aaronadamski/brainsolutions-eegboard/README.md

# brainsolutions-eegboard
EEG Prototype Board for UCI Senior Design

For use in KiCAD EDA Suite.
