aaronadamski/brainsolutions-eegboard/EEG_v2_BOM.xlsx

PrePurch? | ref | Quantity | value | Manufacturer | Part Number | footprint
N | C56 | 1 | 0.5p | Murata | GRM1555C1HR50BZ01D | 0402_NP0_B_50
N | C57 C58 | 2 | 12p | Murata | GRM1555C1H120JA01D | 0402_NP0_J_50
N | C51 C52 | 2 | 15p | Murata | GRM1555C1H150JA01D | 0402_NP0_J_50
N | C54 C55 | 2 | 47p | Murata | GRM1555C1H470JA01D | 0402_NP0_J_50
N | C59 | 1 | 1n | Murata | GRM1555C1H102JA01D | 0402_NP0_J_50
Y | C13 | 1 | 1.5nF | AVX | 08055C152KAT2A | 0805
N | C1 C4 C5 C6 C9 C10 C14 C15 C23 C24 C27 C28 C29 C30 C31 C32 C33 | 17 | 4.7nF | Murata | GRM188R71H472KA01D | 0603_X7R_50
Y | C42 | 1 | 0.01uF | AVX | 08055C103KAT2A | 0805
N | C3 C8 C12 C18 C21 | 5 | 0.1uF | Murata | GRM188R71H104KA93D | 0603_X7R_50
N | C43 C44 C45 C46 C47 C48 C49 C50 C53 | 9 | 1u | Murata | GRM155R60J105KE19D | 0402_X5R_K_6P3
N | C2 C7 C11 C17 C19 C20 C25 C26 C34 C35 C36 C37 | 12 | 1uF | Murata | GRM188R61E105KA12D | 0603_X5R_25
Y | C38 C41 | 2 | 1uF | AVX | 08055YC105KAT2A | 0805
Y | C39 C40 | 2 | 2.2uF | AVX | 0805ZD225MAT2A | 0805
Y | C22 | 1 | 10uF | AVX | 08056D106MAT2A | 0805_X5R_10
Y | C16 | 1 | 100uF | AVX | F930J107MBA | 1210_X5R_10
N | D1 | 1 | LED_EL19-21SURC | Everlight | EL-19-21SURC/S530-A2/TR8 | 0603
N | D2 | 1 | LED_EL19-21SYGC | Everlight | 19-21SYGC/S530-E1/TR8 | 0603
 | JP1 | 1 | JUMPER |  |  | 2x1 0.1"
N | L1 | 1 | EMI | Murata | BLM15HG102SN1D | 0402
 | P1 | 1 | CONN_2 |  |  | 2x1 0.1"
 | P6 | 1 | CONN_3 |  |  | 3x1 0.1"
N | P3 | 1 | USB-MINI-B | Molex | 47346-0001 | 47346-0001
 | P5 | 1 | CONN_5X2 |  |  | 5x2 0.1"
 | P2 P4 | 2 | CONN_8 |  |  | 8x1 0.1" |  | Footprints to do
N | R21 | 1 | 0 | KOA | RK73Z1ETTP | 402 | x | 2x1 0.1"
N | R23 R24 | 2 | 33 | KOA | RK73H1ETTP33R0F | 0402_G | x | 8x1 0.1"
N | R25 R26 | 2 | 270 | KOA | RK73H1ETTP2700F | 0402_F | x | 3x1 0.1"
N | R27 | 1 | 2.2k | KOA | RK73H1ETTP2201F | 0402_G | x | 5x2 0.1"
N | R2 R3 R4 R5 R6 R7 R8 R10 R11 R12 R13 R14 R15 R16 R17 R18 R19 R20 | 18 | 4.99K | Vishay | CRCW06034K99FKEA | 0603 | x | 47346-0001
N | R1 | 1 | 10K | Vishay | CRCW060310K0FKEA | 0603 | x | thru 1825910
N | R22 | 1 | 56k | KOA | RK73H1ETTP5602F | 0402_F | x | VQFN40
Y | R9 | 1 | 1M | Vishay | CRCW08051M00FKEA | 0805 |  | 2450bm15a0002e
N | SW1 | 1 | SWITCH_INV | ALPS | SSSS810701 | SSSS810701 | x | crystal1
 | SW2 | 1 | RESET | TE Connectivity | 2-1825910-7 | Thru 1825910 | x | crystal2
N | SW3 SW4 | 2 | SW_PUSH | TE Connectivity | 2-1825910-7 | Thru 1825910 | x | ssss810701
 | TP2 | 1 | 2.5V |  | N/A | Meas_Pt
 | TP1 | 1 | 3.3V |  | N/A | Meas_Pt
 | TP3 | 1 | -3.3V |  | N/A | Meas_Pt
 | TP4 | 1 | -2.5V |  | N/A | Meas_Pt
N | U7 | 1 | 2450BM15A0002E | Johanson | 2450BM15A0002E | 2450BM15A0002E
Y | U4 | 1 | LM2664 | TI | LM2664M6X/NOPB | SOT23-6
Y | U1 | 1 | ADS1299IPAGR | TI | ADS1299IPAGR | TQFP64
Y | U2 | 1 | TLV70033 | TI | TLV70033DDCR | TSOT23-5
Y | U3 | 1 | TLV70025 | TI | TLV70025DDCR | TSOT23-5
Y | U5 | 1 | TPS72325 | TI | TPS72325DBVR | TSOT23-5
Y | U6 | 1 | CC2540 | TI | CC2540F256RHAR | VQFN40
N | X2 | 1 | 32-MHz | Epson | FA-128 32.0000MF20X-K3 | 10/20/60/10
N | X1 | 1 | 32.768-KHz | Epson | FC-135 32.7680KA-A3 | ~
