aaronadamski/brainsolutions-eegboard/Reference designs/eval/CC2540EM_discrete_partlist.xls

Sheet: Partlist TI LPW
CC2540EM discrete 1.5.1
Mark assembled PCB "CC2540EM_D_R1.5.1"
Use with PCB rev 1.5
Ref. | Part name | Pcs/unit | Description | Manufacturer | Part number | Supplier | Ordering code | Alt. Manufacturer | Alt. Part number | Alt. Supplier | Alt. Ordering code | Comments
U1 | CC2540 | 1 | 2.4 GHz SoC | TI | CC2540 | TI | CC2540
C2 | C_0402 | 0 | Capacitor, general, 0402; Do not mount
C101;C211;C241;C271;C311 | C_100N_0402_X5R_K_10 | 5 | Capacitor, 100n, 0402, X5R, 10%, 10V | Murata | GRM155R71A104KA01D
C221;C231 | C_12P_0402_NP0_J_50 | 2 | Capacitor, 12p, 0402, NP0, 5%, 50V | Murata | GRM1555C1H120JZ01D
C321;C331 | C_15P_0402_NP0_J_50 | 2 | Capacitor, 15p, 0402, NP0, 5%, 50V | Murata | GRM1555C1H150JZ01D
C251;C261 | C_18P_0402_NP0_J_50 | 2 | Capacitor, 18p, 0402, NP0, 5% 25V | Murata | GRM1555C1H180JZ01D | ELFA | 65-881-23
C201 | C_1N_0402_NP0_J_50 | 1 | Capacitor, 1n, 0402, NP0, 5%, 50V | Murata | GRM1555C1H102JA01D
C252-253;C262 | C_1P0_0402_NP0_C_50 | 3 | Capacitor, 1p, 0402, NP0, +/-0.25pF 50V | Murata | GRM1555C1H1R0CZ01D
C391;C401 | C_1U_0402_X5R_K_6P3 | 2 | Capacitor, 1u, 0402, X5R, 10%, 6.3V | Murata | GRM155R60J105KE19D
C272 | C_220P_0402_NP0_J_50 | 1 | Capacitor, 220p, 0402, NP0, 5%, 50V | Murata | GRM1555C1H221JA01D
C1 | C_2U2_0402_X5R_M_6P3VDC | 1 | Capacitor, 2u2, 0402, X5R, +/-20%, 6.3V | Murata | GRM155R60J225ME | TTI
L252 | L_1N0_0402_S | 1 | Inductor, 1n0, 0402, Monolithic type, +/-0.3 nH | Murata | LQG15HS1N0S02D |  |  | Coilcraft
L251;L261 | L_2N0_0402_S | 2 | Inductor, 2n0, 0402, +/-0.3 nH | Murata | LQG15HS2N0S02D
L253 | L_3N0_0402_S | 1 | Inductor, 3n0, 0402, Monolithic type, +/-0.3 nH | Murata | LQG15HS3N0S02D | ACTE |  | Coilcraft
L1 | L_BEAD_102_0402 | 1 | EMI filter bead, 0402 1Kohms Tape GHz Band Gen Use | Murata | BLM15HG102SN1D | ACTE
R1-4 | R_0402 | 0 | Resistor, general, 0402; Do not mount
R201 | R_2K7_0402_F | 1 | Resistor, 2k7 ohms, 0402, ±1% | Koa | RK73H1ETTP2701F | ELFA | 60-482-50
R301 | R_56K_0402_F | 1 | Resistor, 56k ohms, 0402, ±1% | Koa | RK73H1ETTP5602F | ELFA | 60-488-96
P3 | SMA_SMD | 1 | SMA connector, straight SMD-mount | Hus-Tsan Group Taiwan | SMA-10V21-TGG | EC Partner A/S | SMA-10V21-TGG |  |  | AFU, Arrow
P1-2 | SMD_SOCKET_2x10 | 2 | SMD pinrow socket, .050 spacing, 2x10 | Samtec | SFM-110-02-SM-D-A-K-TR | Abacus |  |  |  | AFU, Arrow
X1 | X_32.000/10/20/60/10 | 1 | Crystal, 32 MHz, FA-128 -40/+85C, 10pF, | Epson Toyocom | FA-128, 32MHZ, 10PPM, 10PF, 2x1.6mm, -40/+85C, | ACTE | Q22FA1280009200
X2 | X_32.768/20/50/40/12 | 1 | Crystal, 32.768 kHz, 12.5pF, 20/50 ppm,SMD package | Epson Toyocom | MC-306 | ACTE | Q13MC3061000314 |  |  | EC-Partner
Total |  | 32

Sheet: Part List CadStar
CC2540 | Single chip BLE | 1 | U1
C_0402 | Capacitor 0402, general | 1 | C2
C_100N_0402_X5R_K_10 | Capacitor 0402 | 5 | C101;C211;C241;C271;C311
C_12P_0402_NP0_J_50 | Capacitor 0402 | 2 | C221;C231
C_15P_0402_NP0_J_50 | Capacitor, 0402 | 2 | C321;C331
C_18P_0402_NP0_J_50 | Capacitor 0402 | 2 | C251;C261
C_1N_0402_NP0_J_50 | Capacitor 0402 | 1 | C201
C_1P0_0402_NP0_C_50 | Capacitor 0402 | 3 | C252-253;C262
C_1U_0402_X5R_K_6P3 | Capacitor 0402 | 2 | C391;C401
C_220P_0402_NP0_J_50 | Capacitor 0402 | 1 | C272
C_2U2_0402_X5R_M_4VDC | Capasitor 0402, GRM155R60G225ME15J | 1 | C1
FIDUCIAL_MARK_1MM | Fiducial mark, 1mm metal diameter | 6 | FM1-6
L_1N0_0402_S | Inductor 0402 | 1 | L252
L_2N0_0402_S | Inductor 0402 | 2 | L251;L261
L_3N0_0402_S | Inductor 0402 | 1 | L253
L_BEAD_102_0402 | EMI filter bead, BLM15HG102SN1D | 1 | L1
R_0402 | Resistor 0402, general | 4 | R1-4
R_2K7_0402_F | Resistor 0402 | 1 | R201
R_56K_0402_F | Resistor 0402 | 1 | R301
SMA_SMD | Surface-mount SMA, straight | 1 | P3
SMD_SOCKET_2x10 | SMD pinrow socket, .050 spacing, SFM-110-02-SM-D-A-K-TR | 2 | P1-2
X_32.000/10/20/60/10 | Epson Toyocom FA128 32 MHz 2x1.6mm 10 pF, -40/85C, Q22FA1280009200 | 1 | X1
X_32.768/20/50/40/12 | Crystal, MC-306 SMD | 1 | X2

Sheet: Parts Not To List
FIDUCIAL_MARK
ANTENNA_IIFA_CC2420
HOLE_4.2
FIDUCIAL_MARK_1MM
HOLE_5

Sheet: Parts To Set Count To Zero
R_0402
R_0603
R_0805
C_0402
C_0603
C_0805
L_0402
L_0603
L_0805

Sheet: Parts Removed
FM1-6 | FIDUCIAL_MARK_1MM | 6 | #N/A | #N/A | #N/A | #N/A | #N/A | #N/A | #N/A | #N/A | #N/A | #N/A

Sheet: Parts Count Set To Zero
C2 | C_0402 | 1 | Capacitor, general, 0402; Do not mount
R1-4 | R_0402 | 4 | Resistor, general, 0402; Do not mount
