aaronadamski/brainsolutions-eegboard/Reference designs/cc2511 ref for antenna/IFA_USB.dxf

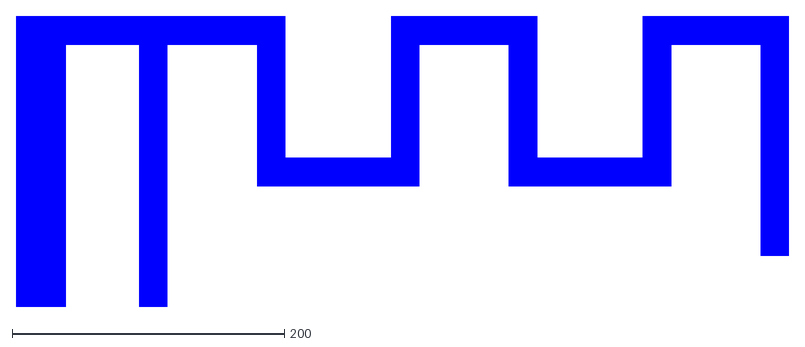
[picture p1: CAD file, 2015-02-03]
Reference designs/cc2511 ref for antenna/IFA_USB.dxf
567.9 x 213.2
