aaronadamski/brainsolutions-eegboard/test.txt

Test file for linux commit. Will be removed.
