aaronadamski/brainsolutions-eegboard/Reference designs/eval/CC2540EM_discrete_schematic.pdf

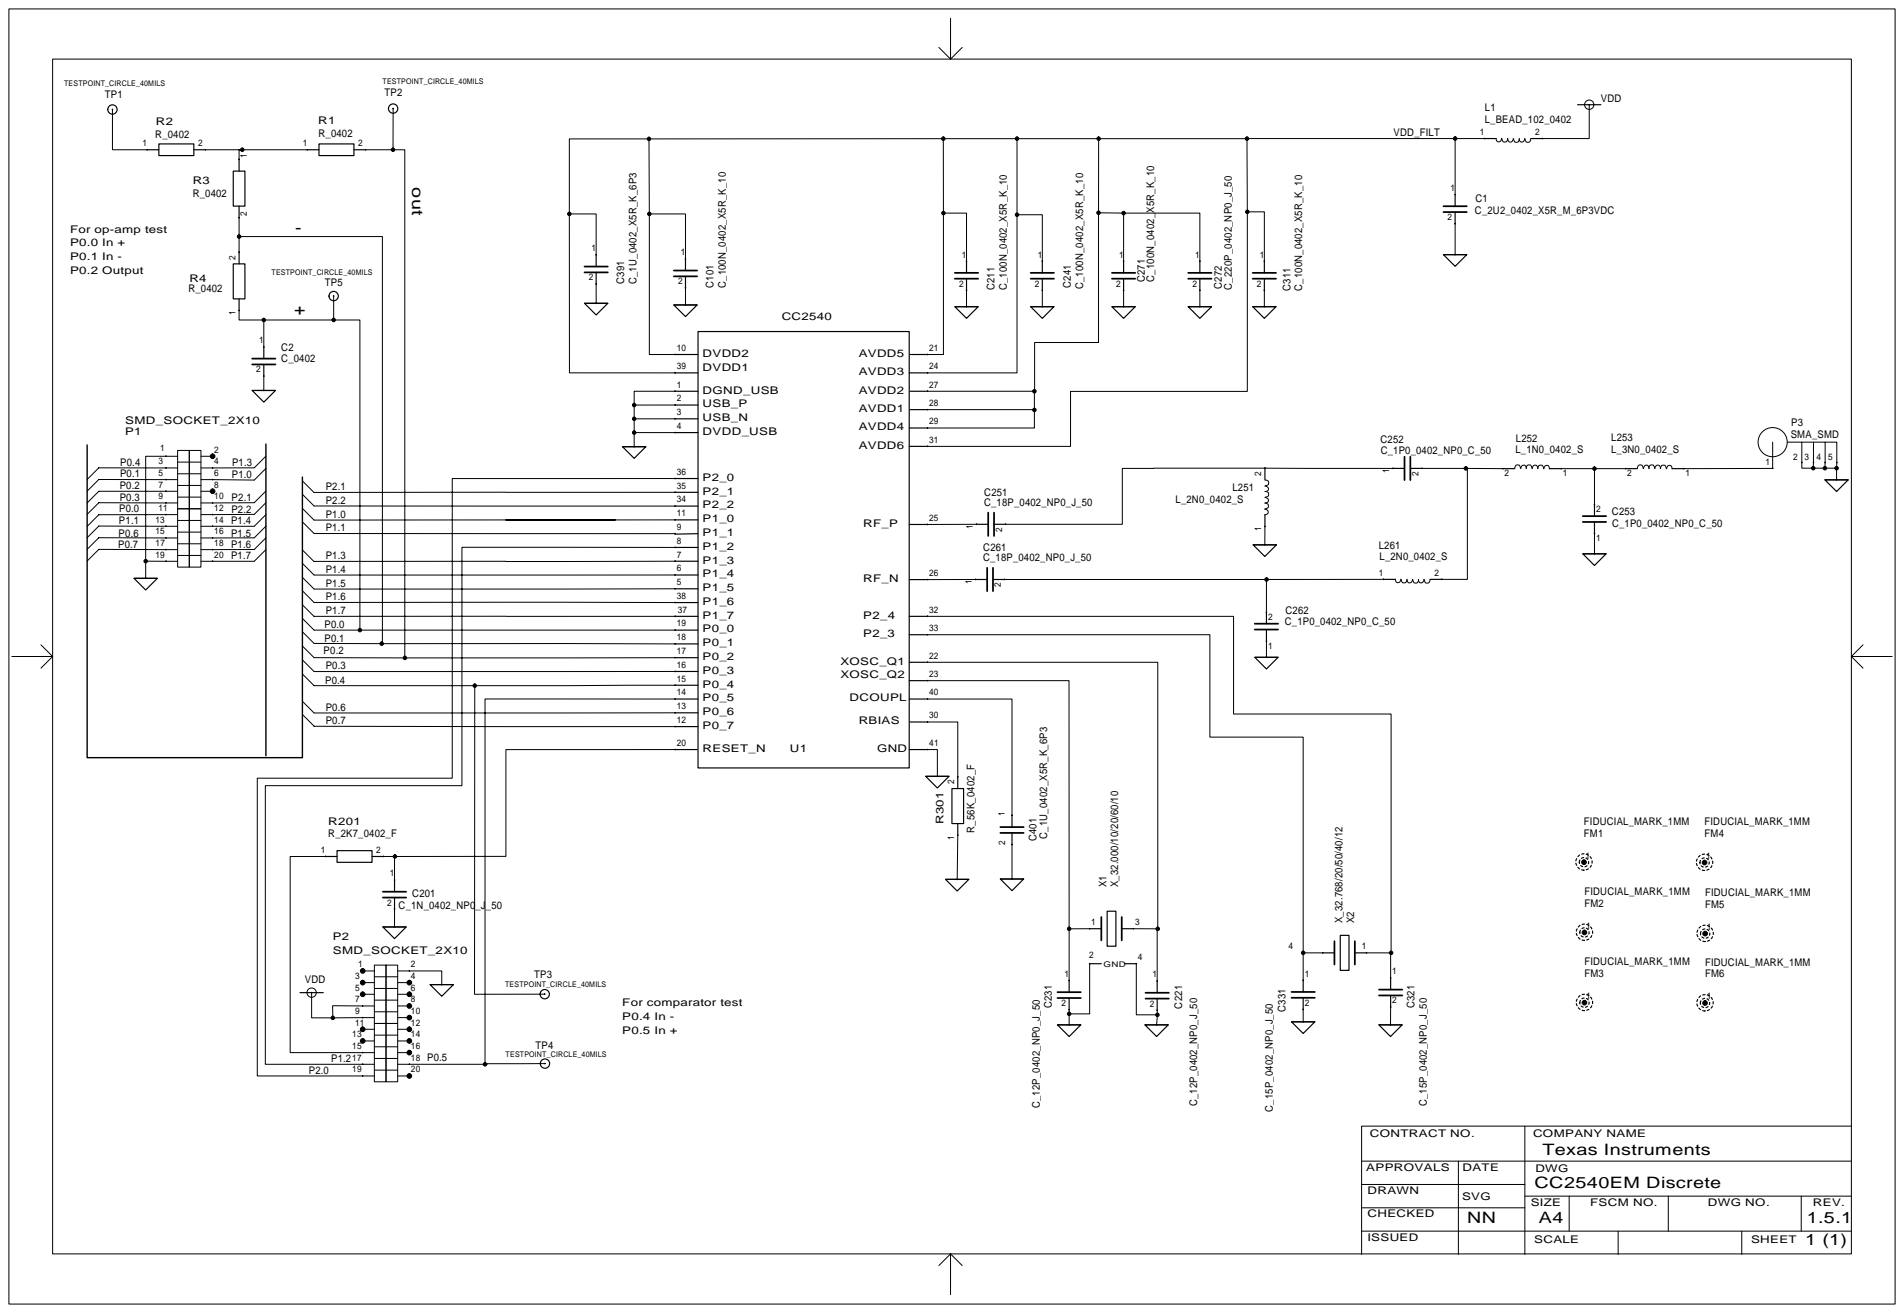
[picture p2: page 1]
