aaronadamski/brainsolutions-eegboard/(list of files, drawings)

Other design files:
EEG_v2_anttest.dsn
EEG_v2_auto.dsn
Reference designs/cc2511 ref for antenna/CC2511_USB_Dongle_1_3.pcb
Reference designs/eval/CC2540EM_discrete.pcb
Reference designs/usb dongle/CC2540_USB_Dongle.pcb
