aaronadamski/brainsolutions-eegboard/EEG_v2.kicad_pcb

## KiCad design EEG_v2.kicad_pcb (2015-02-04)

Schematic: EEG_v2.sch, Project Synapse Prototype Board

Parts:
JP1: JUMPER; 2x1 0.1\"
P1, P6: CONN_2; 2x1 0.1\"
P2, P4: CONN_8; 8x1 0.1\"
P3: USB_A
P5: CONN_5X2; 5x2 0.1\"
P7: CONN_1
R1: 10K; 0603
SW1: SWITCH_INV; SSSS810701
SW2: RESET

Connections:
+3.3V: R1.1; also elsewhere on the board
/Analog Frontend/AIN1N: P2.2; also elsewhere on the board
/Analog Frontend/AIN1P: P2.1; also elsewhere on the board
/Analog Frontend/AIN2N: P2.4; also elsewhere on the board
/Analog Frontend/AIN2P: P2.3; also elsewhere on the board
/Analog Frontend/AIN3N: P2.6; also elsewhere on the board
/Analog Frontend/AIN3P: P2.5; also elsewhere on the board
/Analog Frontend/AIN4N: P2.8; also elsewhere on the board
/Analog Frontend/AIN4P: P2.7; also elsewhere on the board
/Analog Frontend/AIN5N: P4.2; also elsewhere on the board
/Analog Frontend/AIN5P: P4.1; also elsewhere on the board
/Analog Frontend/AIN6N: P4.4; also elsewhere on the board
/Analog Frontend/AIN6P: P4.3; also elsewhere on the board
/Analog Frontend/AIN7N: P4.6; also elsewhere on the board
/Analog Frontend/AIN7P: P4.5; also elsewhere on the board
/Analog Frontend/AIN8N: P4.8; also elsewhere on the board
/Analog Frontend/AIN8P: P4.7; also elsewhere on the board
/Analog Frontend/BIAS: P7.1; also elsewhere on the board
/Analog Frontend/SRB1: P6.1; also elsewhere on the board
/Analog Frontend/SRB2: P6.2 (PM); also elsewhere on the board
/BATT_+: P1.2 (PM), SW1.3
/Microcontroller/DC: P5.3; also elsewhere on the board
/Microcontroller/DD: P5.4; also elsewhere on the board
/Microcontroller/RESET_N: JP1.2, P5.7, SW2.3; also elsewhere on the board
/Microcontroller/USB_N: P3.2 (D-); also elsewhere on the board
/Microcontroller/USB_P: P3.3 (D+); also elsewhere on the board
/VBUS: P3.1 (VBUS), SW1.1
AGND: P1.1, P3.4 (GND), P3.5 (Shield), P3.6 (Shield), P5.1, SW2.1, SW2.2; also elsewhere on the board
unnamed: JP1.1, R1.2
VIN_RAW: P5.2, P5.9, SW1.2; also elsewhere on the board

Notes on the sheet:
BATT_-

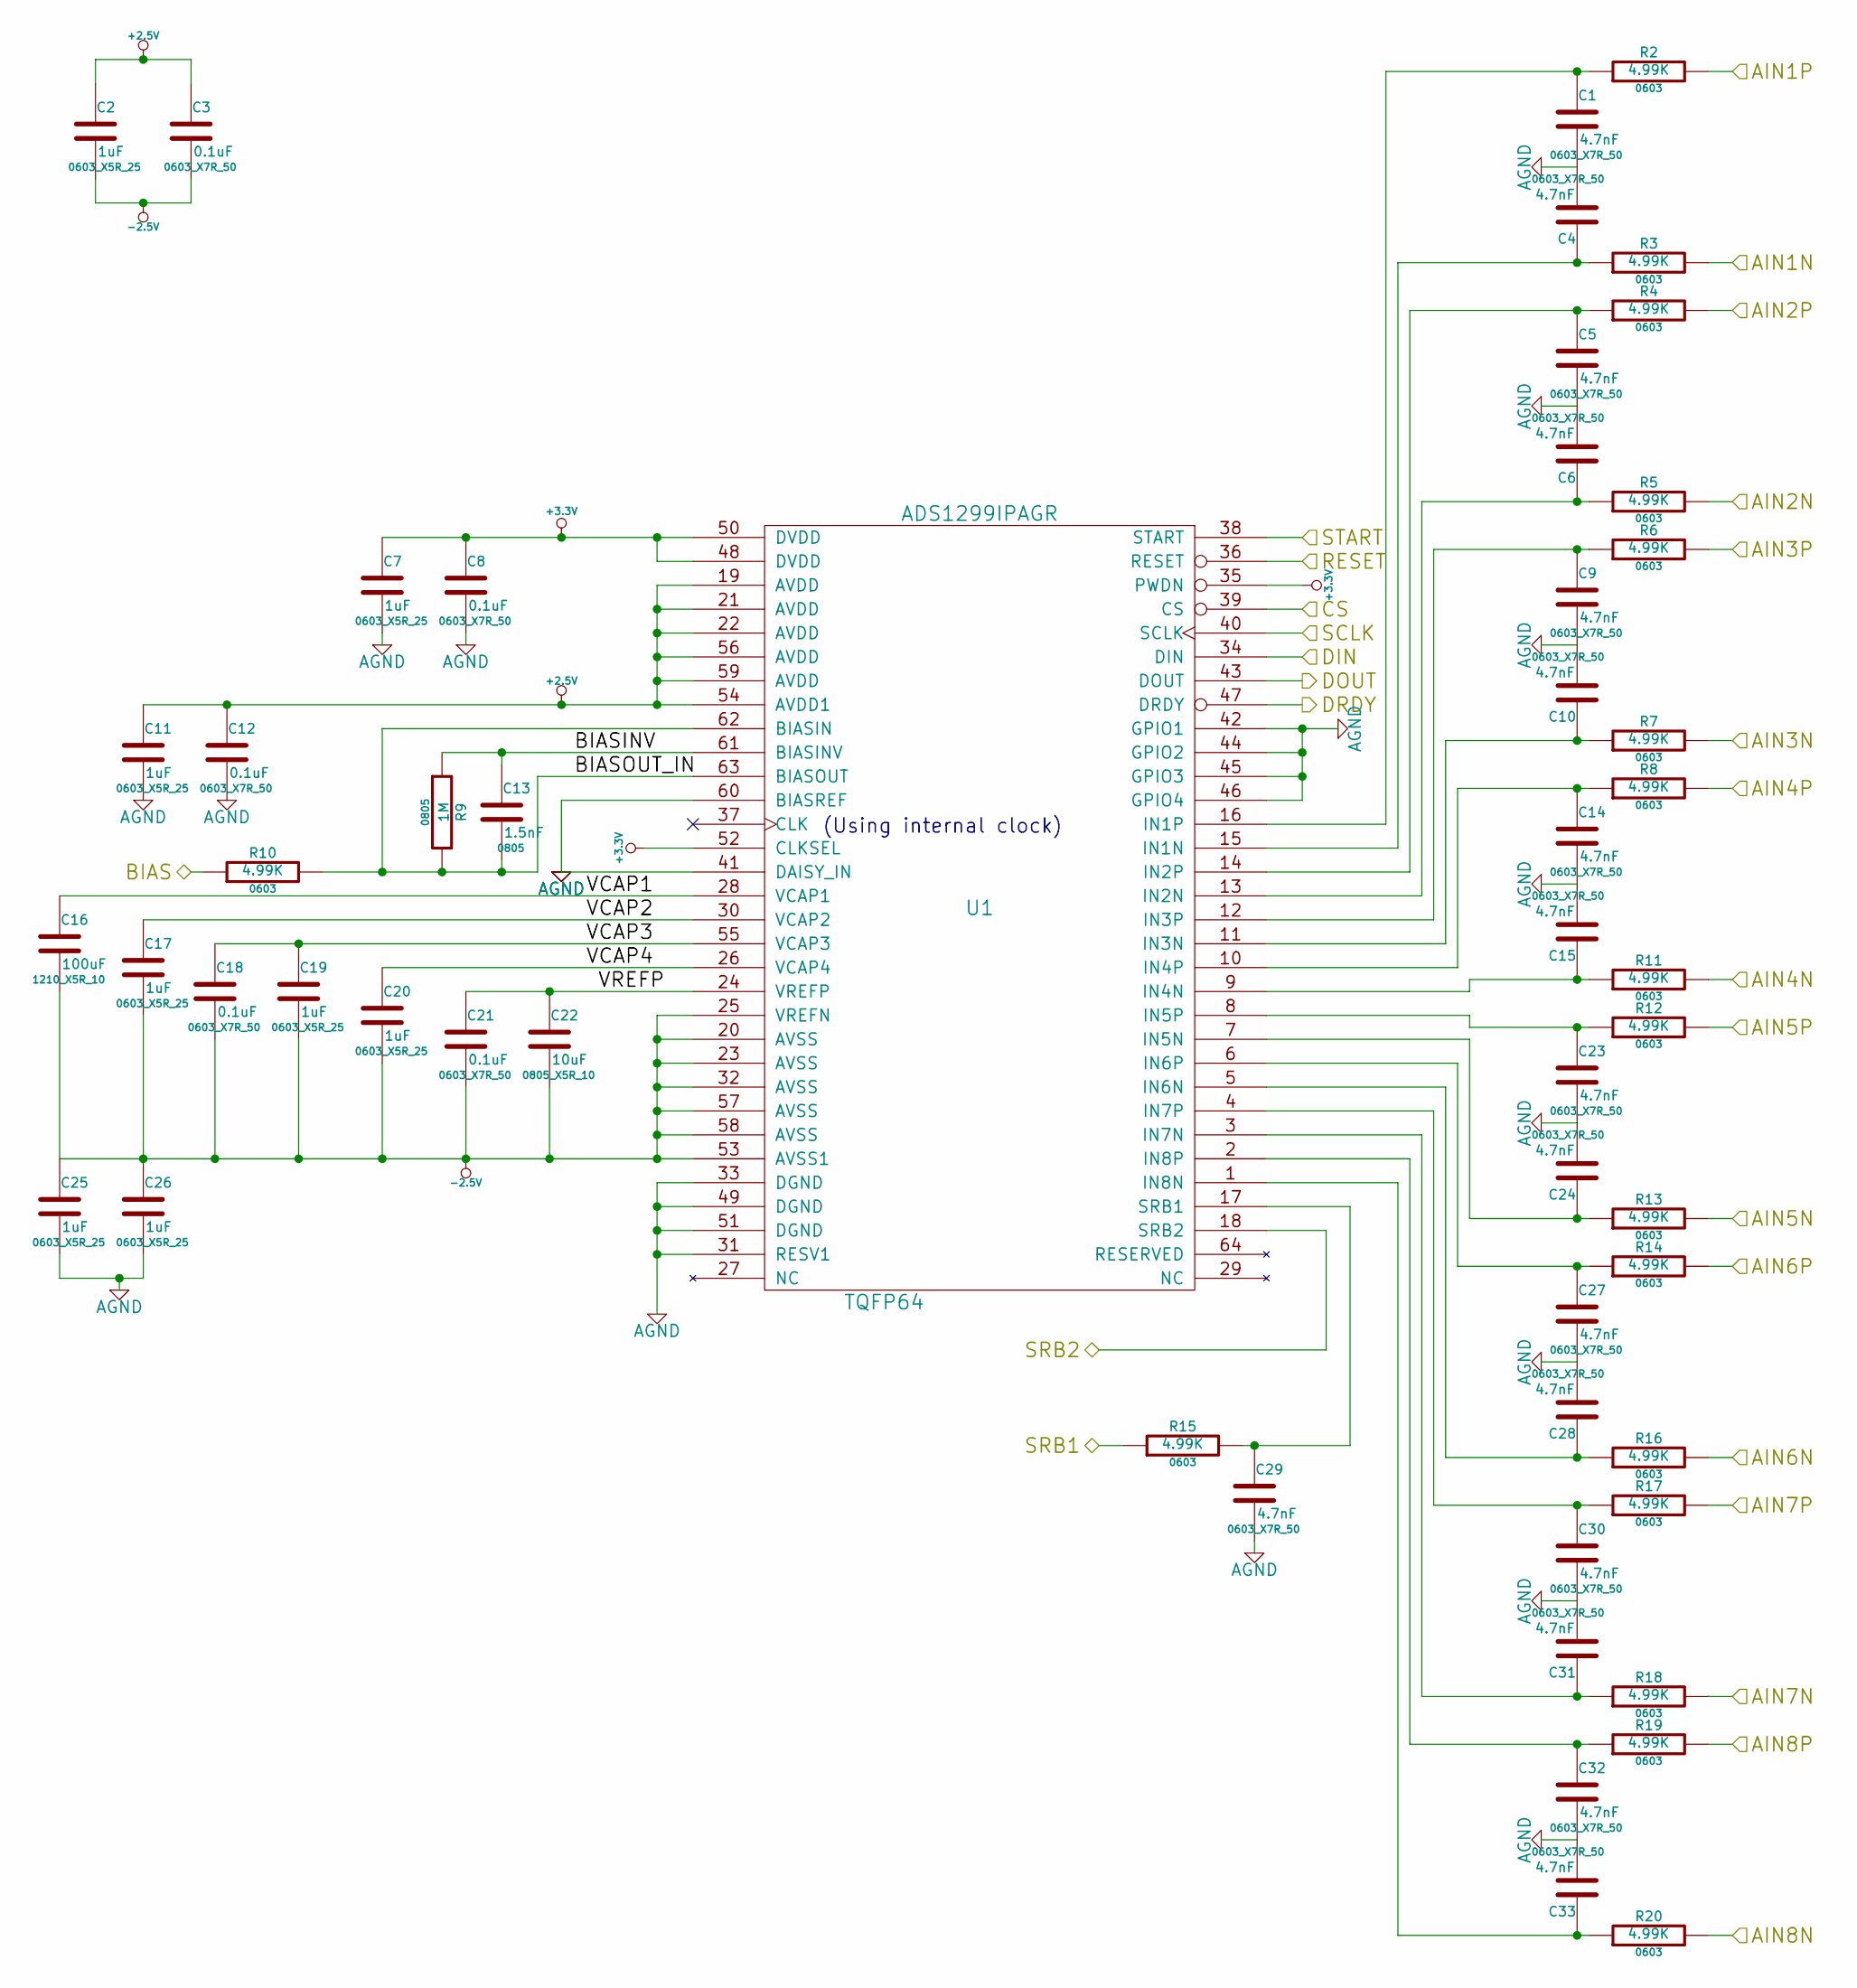
[picture p3: schematic EEG_v2_analog.sch, Project Synapse Prototype Board]

Parts:
C1, C4, C5, C6, C9, C10, C14, C15, C23, C24, C27, C28, C29, C30, C31, C32, C33: 4.7nF; 0603_X7R_50
C2, C7, C11, C17, C19, C20, C25, C26: 1uF; 0603_X5R_25
C3, C8, C12, C18, C21: 0.1uF; 0603_X7R_50
C13: 1.5nF; 0805
C16: 100uF; 1210_X5R_10
C22: 10uF; 0805_X5R_10
R2, R3, R4, R5, R6, R7, R8, R10, R11, R12, R13, R14, R15, R16, R17, R18, R19, R20: 4.99K; 0603
R9: 1M; 0805
U1: ADS1299IPAGR; TQFP64

Connections:
+2.5V: C2.1, C3.1, C11.1, C12.1, U1.19 (AVDD), U1.21 (AVDD), U1.22 (AVDD), U1.54 (AVDD1), U1.56 (AVDD), U1.59 (AVDD); also elsewhere on the board
+3.3V: C7.1, C8.1, U1.35 (PWDN), U1.48 (DVDD), U1.50 (DVDD), U1.52 (CLKSEL); also elsewhere on the board
-2.5V: C2.2, C3.2, C16.2, C17.2, C18.2, C19.2, C20.2, C21.2, C22.2, C25.1, C26.1, U1.20 (AVSS), U1.23 (AVSS), U1.25 (VREFN), U1.32 (AVSS), U1.53 (AVSS1), U1.57 (AVSS), U1.58 (AVSS); also elsewhere on the board
/Analog Frontend/AIN1N: R3.2; also elsewhere on the board
/Analog Frontend/AIN1P: R2.2; also elsewhere on the board
/Analog Frontend/AIN2N: R5.2; also elsewhere on the board
/Analog Frontend/AIN2P: R4.2; also elsewhere on the board
/Analog Frontend/AIN3N: R7.2; also elsewhere on the board
/Analog Frontend/AIN3P: R6.2; also elsewhere on the board
/Analog Frontend/AIN4N: R11.2; also elsewhere on the board
/Analog Frontend/AIN4P: R8.2; also elsewhere on the board
/Analog Frontend/AIN5N: R13.2; also elsewhere on the board
/Analog Frontend/AIN5P: R12.2; also elsewhere on the board
/Analog Frontend/AIN6N: R16.2; also elsewhere on the board
/Analog Frontend/AIN6P: R14.2; also elsewhere on the board
/Analog Frontend/AIN7N: R18.2; also elsewhere on the board
/Analog Frontend/AIN7P: R17.2; also elsewhere on the board
/Analog Frontend/AIN8N: R20.2; also elsewhere on the board
/Analog Frontend/AIN8P: R19.2; also elsewhere on the board
/Analog Frontend/BIAS: R10.1; also elsewhere on the board
/Analog Frontend/BIASINV: C13.1, R9.1, U1.61 (BIASINV)
/Analog Frontend/BIASOUT_IN: C13.2, R9.2, R10.2, U1.62 (BIASIN), U1.63 (BIASOUT)
/Analog Frontend/CS: U1.39 (CS); also elsewhere on the board
/Analog Frontend/DIN: U1.34 (DIN); also elsewhere on the board
/Analog Frontend/DOUT: U1.43 (DOUT); also elsewhere on the board
/Analog Frontend/DRDY: U1.47 (DRDY); also elsewhere on the board
/Analog Frontend/RESET: U1.36 (RESET); also elsewhere on the board
/Analog Frontend/SRB1: R15.1; also elsewhere on the board
/Analog Frontend/SRB2: U1.18 (SRB2); also elsewhere on the board
/Analog Frontend/START: U1.38 (START); also elsewhere on the board
/Analog Frontend/VCAP1: C16.1, U1.28 (VCAP1)
/Analog Frontend/VCAP2: C17.1, U1.30 (VCAP2)
/Analog Frontend/VCAP3: C18.1, C19.1, U1.55 (VCAP3)
/Analog Frontend/VCAP4: C20.1, U1.26 (VCAP4)
/Analog Frontend/VREFP: C21.1, C22.1, U1.24 (VREFP)
/Microcontroller/SCK: U1.40 (SCLK); also elsewhere on the board
AGND: C1.2, C4.2, C5.2, C6.2, C7.2, C8.2, C9.2, C10.2, C11.2, C12.2, C14.2, C15.2, C23.2, C24.2, C25.2, C26.2, C27.2, C28.2, C29.2, C30.2, C31.2, C32.2, C33.2, U1.31 (RESV1), U1.33 (DGND), U1.41 (DAISY_IN), U1.42 (GPIO1), U1.44 (GPIO2), U1.45 (GPIO3), U1.46 (GPIO4), U1.49 (DGND), U1.51 (DGND), U1.60 (BIASREF); also elsewhere on the board
unnamed: C9.1, R6.1, U1.12 (IN3P)
unnamed: C1.1, R2.1, U1.16 (IN1P)
unnamed: C4.1, R3.1, U1.15 (IN1N)
unnamed: C10.1, R7.1, U1.11 (IN3N)
unnamed: C5.1, R4.1, U1.14 (IN2P)
unnamed: C6.1, R5.1, U1.13 (IN2N)
unnamed: C29.1, R15.2, U1.17 (SRB1)
unnamed: C32.1, R19.1, U1.2 (IN8P)
unnamed: C33.1, R20.1, U1.1 (IN8N)
unnamed: C27.1, R14.1, U1.6 (IN6P)
unnamed: C28.1, R16.1, U1.5 (IN6N)
unnamed: C30.1, R17.1, U1.4 (IN7P)
unnamed: C31.1, R18.1, U1.3 (IN7N)
unnamed: C15.1, R11.1, U1.9 (IN4N)
unnamed: C14.1, R8.1, U1.10 (IN4P)
unnamed: C23.1, R12.1, U1.8 (IN5P)
unnamed: C24.1, R13.1, U1.7 (IN5N)

Notes on the sheet:
(Using internal clock)

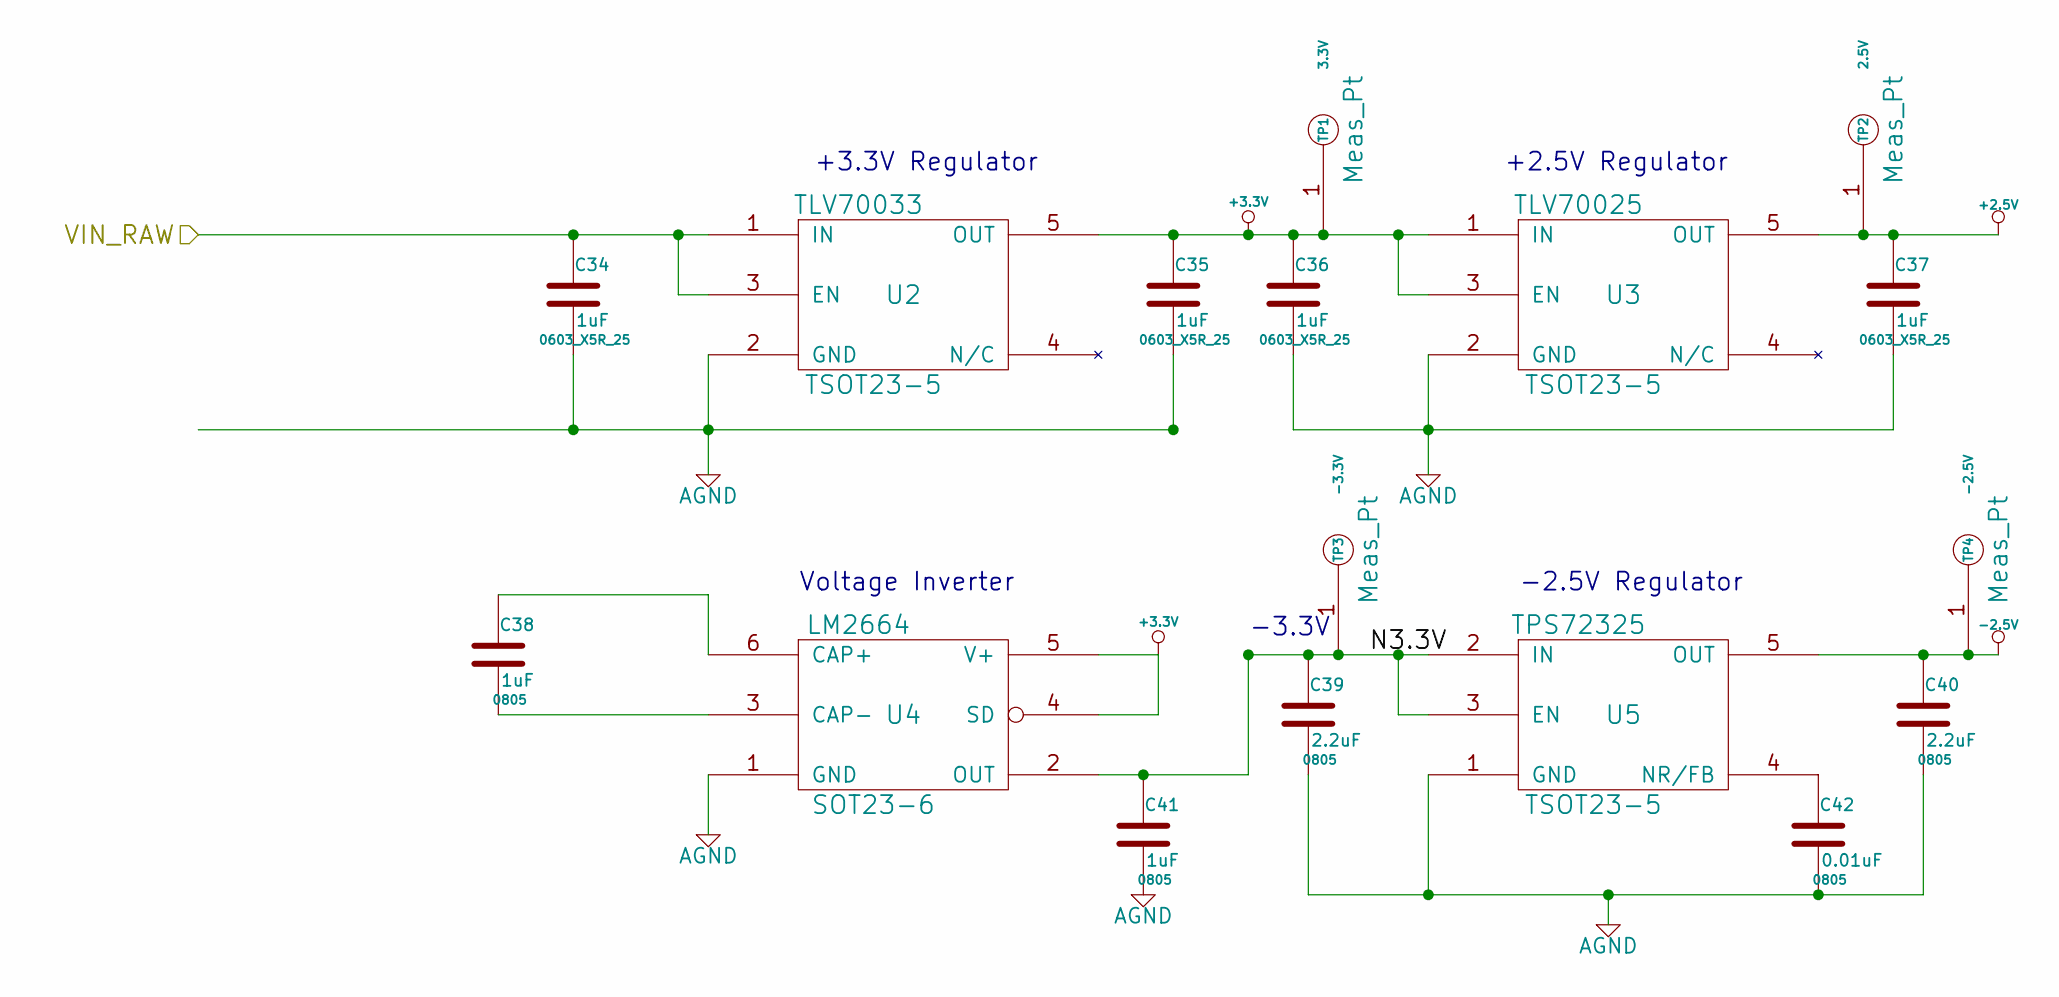
[picture p4: schematic EEG_v2_power.sch, Project Synapse Prototype Board]

Parts:
C34, C35, C36, C37: 1uF; 0603_X5R_25
C38, C41: 1uF; 0805
C39, C40: 2.2uF; 0805
C42: 0.01uF; 0805
TP1: 3.3V; Meas_Pt
TP2: 2.5V; Meas_Pt
TP3: -3.3V; Meas_Pt
TP4: -2.5V; Meas_Pt
U2: TLV70033; TSOT23-5
U3: TLV70025; TSOT23-5
U4: LM2664; SOT23-6
U5: TPS72325; TSOT23-5

Connections:
+2.5V: C37.1, TP2.1, U3.5 (OUT); also elsewhere on the board
+3.3V: C35.1, C36.1, TP1.1, U2.5 (OUT), U3.1 (IN), U3.3 (EN), U4.4 (SD), U4.5 (V+); also elsewhere on the board
-2.5V: C40.1, TP4.1, U5.5 (OUT); also elsewhere on the board
/Power/N3.3V: C39.1, C41.1, TP3.1, U4.2 (OUT), U5.2 (IN), U5.3 (EN)
AGND: C34.2, C35.2, C36.2, C37.2, C39.2, C40.2, C41.2, C42.2, U2.2 (GND), U3.2 (GND), U4.1 (GND), U5.1 (GND); also elsewhere on the board
unnamed: C42.1, U5.4 (NR/FB)
unnamed: C38.1, U4.6 (CAP+)
unnamed: C38.2, U4.3 (CAP-)
VIN_RAW: C34.1, U2.1 (IN), U2.3 (EN); also elsewhere on the board

Notes on the sheet:
+3.3V Regulator
+2.5V Regulator
Voltage Inverter
-3.3V
-2.5V Regulator

Schematic: EEG_v2_micro.sch, Project Synapse Prototype Board

Parts:
A1: AN043
C43, C44, C45, C46, C47, C48, C49, C50, C53: 1u; 0402_X5R_K_6P3
C51, C52: 15p; 0402_NP0_J_50
C54, C55: 47p; 0402_NP0_J_50
C56: 0.5p; 0402_NP0_B_50
C57, C58: 12p; 0402_NP0_J_50
C59: 1n; 0402_NP0_J_50
D1: LED_EL19-21SURC; 0603
D2: LED_EL19-21SYGC; 0603
L1: EMI; 0402
R21: 0; 0402
R22: 56k; 0402_F
R23, R24: 33; 0402_G
R25, R26: 270; 0402_F
R27: 2.2k; 0402_G
SW3, SW4: SW_PUSH_4PIN
U6: CC2540; VQFN40
U7: 2450BM15A0002E
X1: QUARTZCMS4_32K
X2: QUARTZCMS4_MOD

Connections:
+3.3V: L1.2; also elsewhere on the board
/Analog Frontend/CS: U6.18 (P0_1); also elsewhere on the board
/Analog Frontend/DIN: U6.15 (P0_4); also elsewhere on the board
/Analog Frontend/DOUT: U6.14 (P0_5); also elsewhere on the board
/Analog Frontend/DRDY: U6.13 (P0_6); also elsewhere on the board
/Analog Frontend/RESET: U6.12 (P0_7); also elsewhere on the board
/Analog Frontend/START: U6.19 (P0_0); also elsewhere on the board
/Microcontroller/ANTENNA: A1.1 (FEED), R21.2
/Microcontroller/DC: U6.34 (P2_2); also elsewhere on the board
/Microcontroller/DD: U6.35 (P2_1); also elsewhere on the board
/Microcontroller/LED1: R25.2, U6.9 (P1_1)
/Microcontroller/LED2: R26.2, U6.11 (P1_0)
/Microcontroller/RESET_INTR: C59.1, R27.1, U6.20 (RESET_N)
/Microcontroller/RESET_N: R27.2; also elsewhere on the board
/Microcontroller/RF_N: U6.26 (RF_N), U7.3 (Balanced)
/Microcontroller/RF_P: U6.25 (RF_P), U7.4 (Balanced)
/Microcontroller/SCK: U6.16 (P0_3); also elsewhere on the board
/Microcontroller/SW3: SW3.4, U6.7 (P1_3)
/Microcontroller/SW4: SW4.3, U6.8 (P1_2)
/Microcontroller/TX_LINE: C56.1, R21.1, U7.1 (Unbalanced)
/Microcontroller/USB_N: R24.1; also elsewhere on the board
/Microcontroller/USB_N_Intr: C55.1, R24.2, U6.3 (USB_N)
/Microcontroller/USB_P: R23.1; also elsewhere on the board
/Microcontroller/USB_P_Intr: C54.2, R23.2, U6.2 (USB_P)
/Microcontroller/VDD_FILT: C43.1, C44.1, C45.1, C46.1, C47.1, C48.1, C49.1, C50.1, L1.1, U6.4 (DVDD_USB), U6.10 (DVDD2), U6.21 (AVDD5), U6.24 (AVDD3), U6.27 (AVDD2), U6.28 (AVDD1), U6.29 (AVDD4), U6.31 (AVDD6), U6.39 (DVDD1)
/Microcontroller/X1_1: C51.1, U6.33 (P2_3/XOSC32K_Q1), X1.1
/Microcontroller/X1_2: C52.1, U6.32 (P2_4/XOSC32K_Q1), X1.2
/Microcontroller/X2_1: C57.1, U6.22 (XOSC_Q1), X2.1
/Microcontroller/X2_3: C58.1, U6.23 (XOSC_Q2), X2.3
AGND: A1.2 (GND), C43.2, C44.2, C45.2, C46.2, C47.2, C48.2, C49.2, C50.2, C51.2, C52.2, C53.2, C54.1, C55.2, C56.2, C57.2, C58.2, C59.2, D1.2 (K), D2.2 (K), R22.2, SW3.1, SW3.2, SW4.1, SW4.2, U6.1 (DGND_USB), U6.41 (PAD), U7.2 (GND), U7.5 (GND), U7.6 (GND), X2.2, X2.4; also elsewhere on the board
unnamed: R22.1, U6.30 (R_BIAS)
unnamed: C53.1, U6.40 (DCOUPL)
unnamed: D1.1 (A), R25.1
unnamed: D2.1 (A), R26.1

Notes on the sheet:
LED RED
LED GREEN

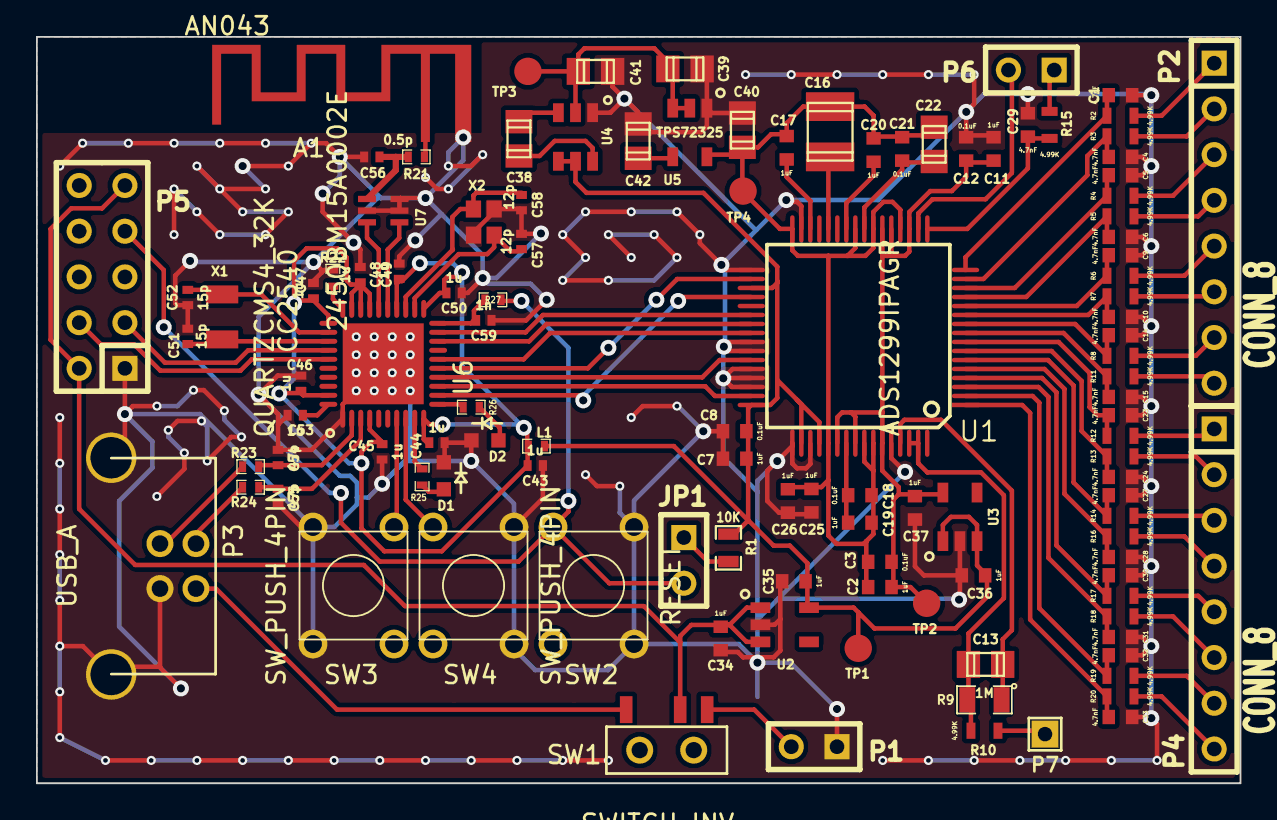
[picture p5: board EEG_v2.kicad_pcb from above]

Board: 2 copper layers, 66.9 x 41.5 mm, 115 parts (0 on the bottom side), 87 nets.
