aaronadamski/brainsolutions-eegboard/(commit log)

2015-01-12 First Commit
    Copied from v1 prototype
    [EEG_v2.kicad_pcb, EEG_v2.sch]
2015-01-12 Created Hierarchy of Sheets
    Divided by power, analog, and microcontroller
    [EEG_v2_analog.sch, EEG_v2_micro.sch, EEG_v2_power.sch]
2015-01-12 Added Datasheets and Application Note for Antenna
    swra117d - antenna design reference
2015-01-13 Added CC2540 Bluetooth chip to library
    Also added CC2540 to sch
    [EEG_v2.sch, EEG_v2_analog.sch, EEG_v2_micro.sch, EEG_v2_power.sch]
2015-01-13 Finished CC2540 Symbol, Added example application schematic
    [EEG_v2_micro.sch]
2015-01-13 Pin connect, add note on Balun and antenna
    [EEG_v2.sch, EEG_v2_micro.sch]
2015-01-14 Following TI Reference design CC2540EM. Added component footprints on micro sheet.
    [EEG_v2.sch, EEG_v2_analog.sch, EEG_v2_micro.sch, EEG_v2_power.sch]
2015-01-15 Finished copy of reference design. Still need to figure out what to do with USB pins. Added Johanson balun.
    [EEG_v2.sch, EEG_v2_analog.sch, EEG_v2_micro.sch, EEG_v2_power.sch]
2015-01-15 Added USB connection.
    [EEG_v2.sch, EEG_v2_analog.sch, EEG_v2_micro.sch, EEG_v2_power.sch]
2015-01-15 Add reference designs.
    [CC2540_USB_Dongle.pcb, CC2540_USB_Dongle_PARTLIST.xls]
2015-01-15 Added capacitors for USB.
2015-01-23 Microcontroller Sheet Work
    Add antenna components and label. Add debug flash hier pins. Add RC
    filter for RESET_N pin. Add heir labels for USB.
    [EEG_v2.sch, EEG_v2_analog.sch, EEG_v2_micro.sch, EEG_v2_power.sch]
2015-01-23 Main sheet cleanup
    Add pins for raw vin and GND for power switching between USB and
    battery.
    [EEG_v2.sch, EEG_v2_power.sch]
2015-01-23 Add USB Connector
    Added desc of USB A connector
    [EEG_v2.sch, EEG_v2_analog.sch, EEG_v2_micro.sch, EEG_v2_power.sch]
2015-01-24 Add battery connectors and switch
    [EEG_v2.sch]
2015-01-24 Added debug / programming connector
    [EEG_v2.sch, EEG_v2_analog.sch, EEG_v2_micro.sch, EEG_v2_power.sch]
2015-01-24 Add note to debug connector for possible change.
    [EEG_v2.sch]
2015-01-24 Changed color of labels to be visible against bg.
    [EEG_v2.sch, EEG_v2_micro.sch]
2015-01-24 Created netlist file to test footprint associations.
2015-01-24 Add symbol and footprints for SMD test points.
    Add test points to power supplies.
    [EEG_v2.sch, EEG_v2_analog.sch, EEG_v2_micro.sch, EEG_v2_power.sch]
2015-01-24 Added footprints to ADS caps, shorted unused GPIO to gnd
    [EEG_v2.sch, EEG_v2_analog.sch, EEG_v2_micro.sch, EEG_v2_power.sch]
2015-01-24 Add decoupling caps btwn AVDD and AVSS
    [EEG_v2_analog.sch]
2015-01-24 Clean ERC errors.
    [EEG_v2.sch, EEG_v2_analog.sch, EEG_v2_micro.sch, EEG_v2_power.sch]
2015-01-27 Added patient protection resistors and filter caps to input electroes
    [EEG_v2.sch, EEG_v2_analog.sch, EEG_v2_micro.sch, EEG_v2_power.sch]
2015-01-27 Added pins for bias and SRB1/2
    [EEG_v2_analog.sch]
2015-01-27 Add RC to SRB1
    [EEG_v2_analog.sch]
2015-01-27 Imported sheet pins to main sheet
    [EEG_v2.sch, EEG_v2_analog.sch]
2015-01-27 Add pin headers for electrodes and debug signals.
    [$EEG_v2.sch, EEG_v2.sch]
2015-01-27 Correct pin headers
    [$EEG_v2.sch, EEG_v2.sch]
2015-01-28 Modify libraries to be correct. Add pushbuttons and LEDs. Change switch to toggle.
    [EEG_v2.sch, EEG_v2_analog.sch, EEG_v2_micro.sch, EEG_v2_power.sch]
2015-01-28 Fix ERC. Generate netlist.
    [EEG_v2_analog.sch]
2015-01-29 Added footprint designators for voltage regulators.
    [EEG_v2.sch, EEG_v2_analog.sch, EEG_v2_micro.sch, EEG_v2_power.sch]
2015-01-29 add eval ref design for cc2540.
    [$EEG_v2_power.sch, CC2540EM_discrete.pcb, CC2540EM_discrete_partlist.xls]
2015-01-29 Add reset button / jumper
    [$EEG_v2_power.sch, EEG_v2.sch, EEG_v2_power.sch]
2015-01-29 Add footprints
    [EEG_v2.sch, EEG_v2_analog.sch, EEG_v2_micro.sch, EEG_v2_power.sch]
2015-01-29 Added footprints to connectors. Changed usb A to usb micro B
    [EEG_v2.sch, EEG_v2_analog.sch, EEG_v2_micro.sch, EEG_v2_power.sch]
2015-01-29 Modified Vbus on usb conn to be power out. Replaced batt connections with 0.1" headers
    [EEG_v2.sch, EEG_v2_analog.sch, EEG_v2_micro.sch, EEG_v2_power.sch]
2015-01-29 Add footprints for tactile switches
    [CC2540_USB_Dongle_PARTLIST.xls, EEG_v2.sch, EEG_v2_analog.sch, EEG_v2_micro.sch]
2015-01-29 Add datasheet for power switch, footprints for test points
    [EEG_v2.sch, EEG_v2_power.sch]
2015-01-29 Add balun datasheet
    [EEG_v2_micro.sch]
2015-01-29 Correct 32k crystal
    [CC2540EM_discrete_partlist.xls, EEG_v2.csv, EEG_v2_micro.sch]
2015-01-30 Associate footprints to pcbnew
    [CC2540EM_discrete_partlist.xls, EEG_v2.csv, EEG_v2_BOM.xlsx, EEG_v2_analog.sch, EEG_v2_micro.sch]
2015-01-30 Made some footprints
    [EEG_v2_BOM.xlsx]
2015-01-30 Create CC2540 footprint and edit pad name
2015-01-30 Association of footprints. Add footprints, one left. Add datasheets. Update BOM
    [EEG_v2_BOM.xlsx]
2015-01-31 Begin layout. Finish footprints and association.
    [EEG_v2.sch, EEG_v2_analog.sch, EEG_v2_micro.sch, EEG_v2_power.sch]
2015-02-01 Continued layout work.
    [EEG_v2.kicad_pcb, EEG_v2_analog.sch, EEG_v2_power.sch]
2015-02-01 Change USB connector. Continue layout.
    [EEG_v2.kicad_pcb, EEG_v2.sch, EEG_v2_analog.sch, EEG_v2_micro.sch, EEG_v2_power.sch]
2015-02-01 Change layout.
    [EEG_v2.kicad_pcb]
2015-02-01 Continue layout on ADS side, power supplies complete.
    [EEG_v2.kicad_pcb, EEG_v2_analog.sch]
2015-02-01 Name nets for convenience on CC2540.
    [EEG_v2.kicad_pcb, EEG_v2_micro.sch]
2015-02-02 Continue layout.
    [EEG_v2.kicad_pcb]
2015-02-02 Continue layout for CC2540
    Change swiches to one pin operating to clear under space. Edit USB conn
    to show back size.
    [EEG_v2.kicad_pcb, EEG_v2.sch, EEG_v2_analog.sch, EEG_v2_micro.sch, EEG_v2_power.sch]
2015-02-03 Continue layout, compress chips together.
    [EEG_v2.kicad_pcb, EEG_v2.sch, EEG_v2_analog.sch, EEG_v2_micro.sch, EEG_v2_power.sch]
2015-02-03 Continue layout and add antenna
    [CC2511_USB_Dongle_1_3.pcb, EEG_v2.kicad_pcb, EEG_v2_micro.sch, IFA_USB.dxf]
2015-02-03 Continue layout. Add fill zones.
    [EEG_v2.kicad_pcb, EEG_v2.sch, EEG_v2_micro.sch]
2015-02-03 Add autoroute version
    [EEG_v2.kicad_Auto_pcb.kicad_pcb]
2015-02-03 add auto verison
    [EEG_v2_auto.kicad_pcb]
2015-02-03 Tested autorouter. ehhhh.
    [EEG_v2_auto.dsn, EEG_v2_auto.kicad_pcb]
2015-02-04 Continue layout, test antenna workings
    [EEG_v2.drl, EEG_v2.gbl, EEG_v2.gbo, EEG_v2.gbs, EEG_v2.gko, EEG_v2.gtl, EEG_v2.gto, EEG_v2.gts]
2015-02-04 Continue layout experiment with add antenna
    [EEG_v2.kicad_pcb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]
2015-02-04 Nearly finished layout
    [EEG_v2-F_Cu_cam.gtl, EEG_v2-F_Paste.gtp, EEG_v2.drl, EEG_v2.gbl, EEG_v2.gbo, EEG_v2.gbs, EEG_v2.gko, EEG_v2.gto]
2015-02-04 Final layout submitted.
    [EEG_v2.kicad_pcb]
